Jackpot17/keyboard/keyboard/keyboard.kicad_pcb

## KiCad design keyboard/keyboard.kicad_pcb (2026-11-12)

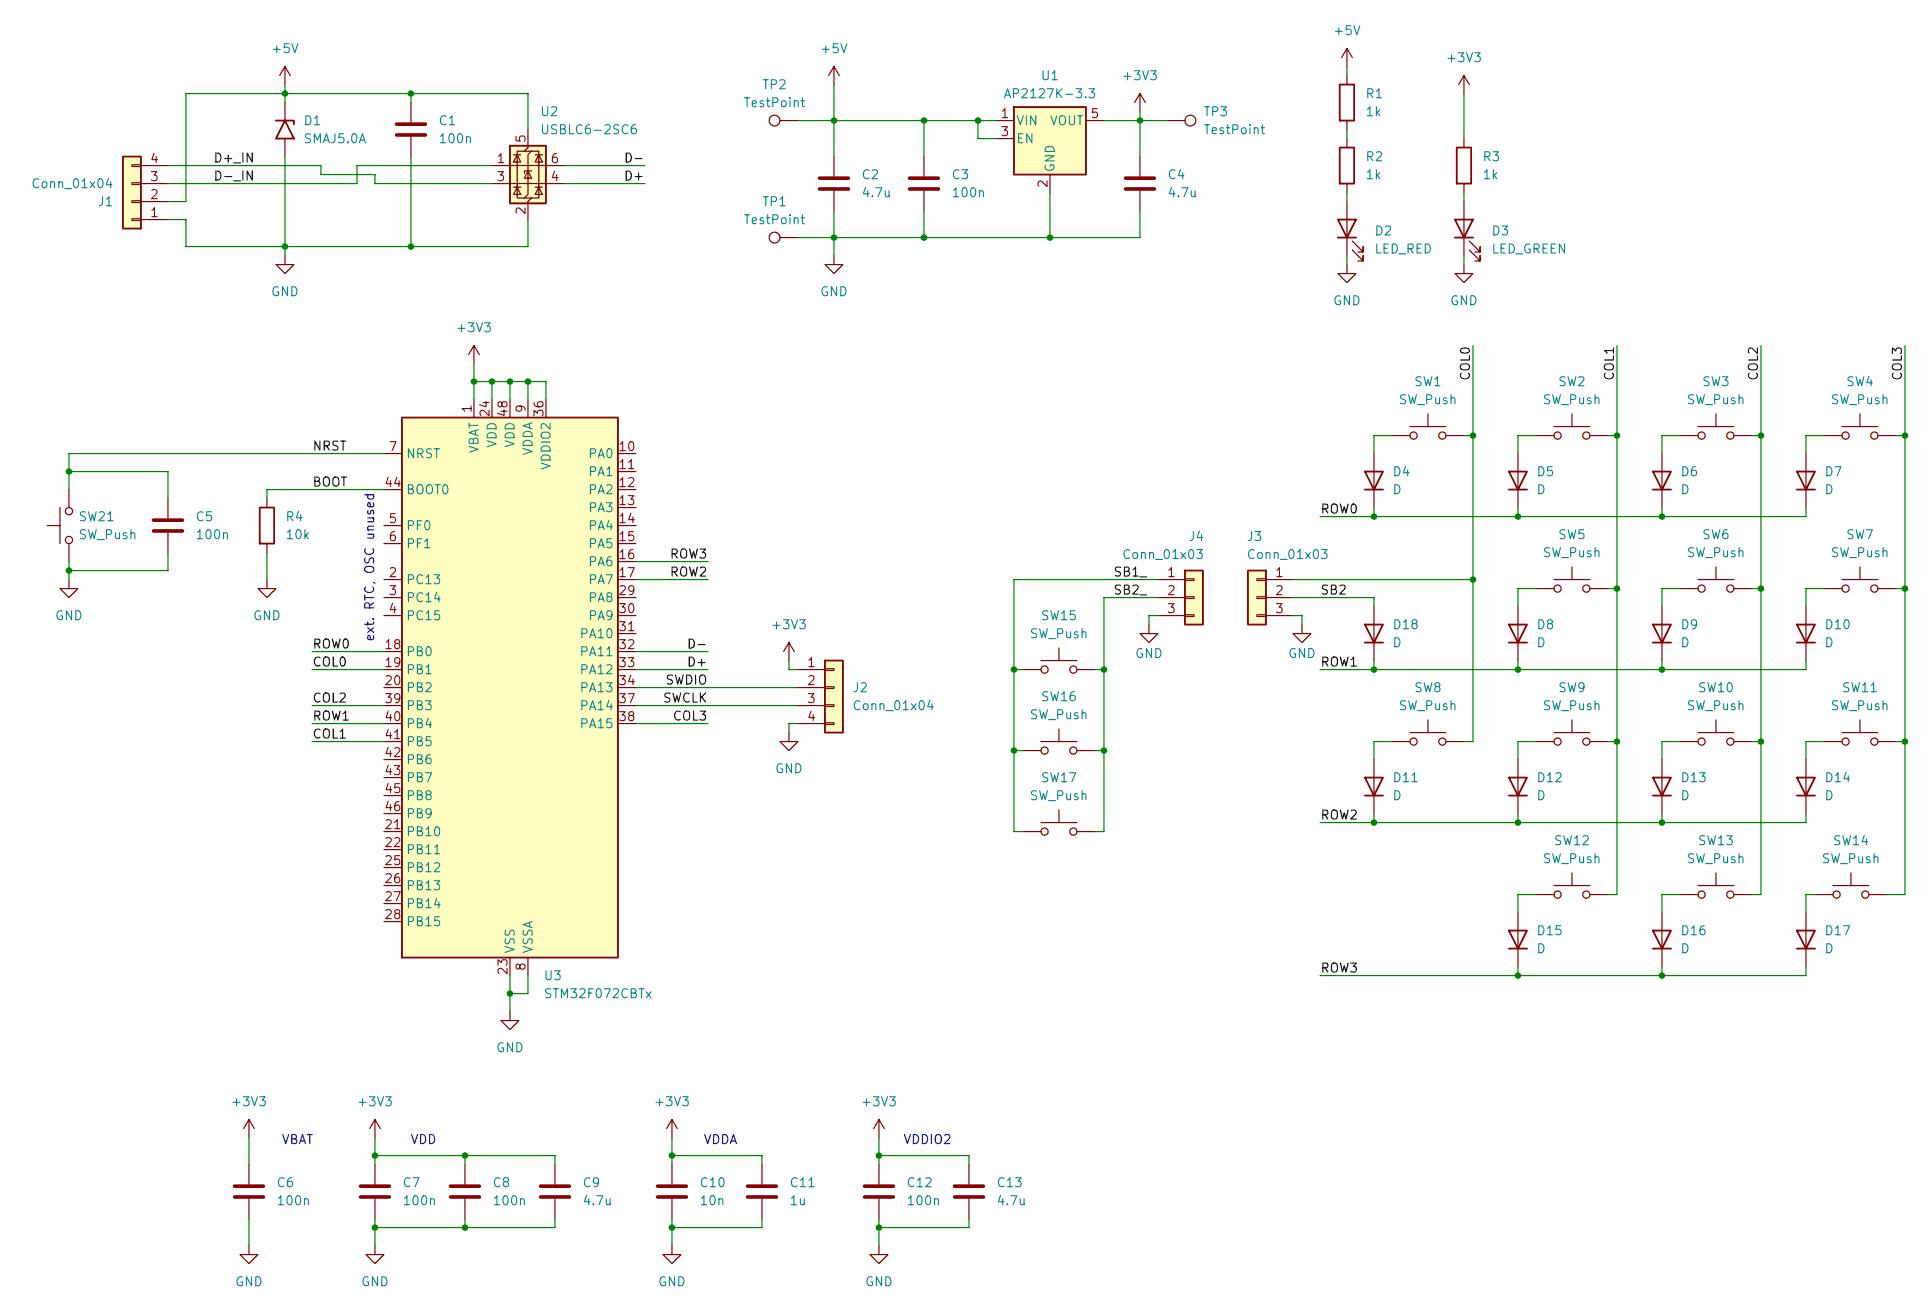
[picture p1: schematic keyboard.kicad_sch]

Parts:
C1, C3, C5, C6, C7, C8, C12: 100n; C_0603_1608Metric
C2, C4: 4.7u; C_0805_2012Metric
C9, C13: 4.7u; C_0603_1608Metric
C10: 10n; C_0603_1608Metric
C11: 1u; C_0603_1608Metric
D1: SMAJ5.0A; D_SMA
D2: LED_RED; LED_0603_1608Metric
D3: LED_GREEN; LED_0603_1608Metric
D4, D5, D6, D7, D8, D9, D10, D11, D12, D13, D14, D15, D16, D17, D18: D; D_SOD-323
J1: Conn_01x04
J2: Conn_01x04; PinHeader_1x04_P1.27mm_Vertical
J3, J4: Conn_01x03
R1, R2, R3: 1k; R_0603_1608Metric
R4: 10k; R_0603_1608Metric
SW1, SW2, SW3, SW4, SW5, SW6, SW7, SW8, SW9, SW10, SW11, SW12, SW13, SW14, SW15, SW16, SW17: SW_Push; SW_MX_HS_KS-2P02B01-01_1.5u
SW21: SW_Push; SW_SPST_TL3305A
TP1, TP2, TP3: TestPoint; TestPoint_Pad_D1.0mm
U1: AP2127K-3.3; SOT-23-5
U2: USBLC6-2SC6; SOT-23-6
U3: STM32F072CBTx; LQFP-48_7x7mm_P0.5mm

Connections:
+3V3: C4.1, C6.1, C7.1, C8.1, C9.1, C10.1, C11.1, C12.1, C13.1, J2.1, R3.1, TP3.1 (1_1), U1.5 (VOUT), U3.1 (VBAT), U3.9 (VDDA), U3.24 (VDD), U3.36 (VDDIO2), U3.48 (VDD)
+5V: C1.1, C2.1, C3.1, D1.1 (A1), J1.2, R1.1, TP2.1 (1_1), U1.1 (VIN), U1.3 (EN), U2.5 (VBUS); also elsewhere on the board
/BOOT: R4.1, U3.44 (BOOT0)
/COL0: J3.1, SW1.2, SW8.2, U3.19 (PB1); also elsewhere on the board
/COL1: SW2.2, SW5.2, SW9.2, SW12.2, U3.41 (PB5)
/COL2: SW3.2, SW6.2, SW10.2, SW13.2, U3.39 (PB3)
/COL3: SW4.2, SW7.2, SW11.2, SW14.2, U3.38 (PA15)
/D+: U2.4 (I/O2), U3.33 (PA12)
/D+_IN: J1.4, U2.3 (I/O2); also elsewhere on the board
/D-: U2.6 (I/O1), U3.32 (PA11)
/D-_IN: J1.3, U2.1 (I/O1); also elsewhere on the board
/NRST: C5.1, SW21.2, U3.7 (NRST)
/ROW0: D4.1 (K), D5.1 (K), D6.1 (K), D7.1 (K), U3.18 (PB0)
/ROW1: D8.1 (K), D9.1 (K), D10.1 (K), D18.1 (K), U3.40 (PB4)
/ROW2: D11.1 (K), D12.1 (K), D13.1 (K), D14.1 (K), U3.17 (PA7)
/ROW3: D15.1 (K), D16.1 (K), D17.1 (K), U3.16 (PA6)
/SB1_: J4.1, SW15.1, SW16.1, SW17.1; also elsewhere on the board
/SB2: D18.2 (A), J3.2; also elsewhere on the board
/SB2_: J4.2, SW15.2, SW16.2, SW17.2; also elsewhere on the board
/SWCLK: J2.3, U3.37 (PA14)
/SWDIO: J2.2, U3.34 (PA13)
GND: C1.2, C2.2, C3.2, C4.2, C5.2, C6.2, C7.2, C8.2, C9.2, C10.2, C11.2, C12.2, C13.2, D1.2 (A2), D2.1 (K), D3.1 (K), J1.1, J2.4, J3.3, J4.3, R4.2, SW21.1, TP1.1 (1_1), U1.2 (GND), U2.2 (GND), U3.8 (VSSA), U3.23 (VSS), U3.35 (VSS), U3.47 (VSS); also elsewhere on the board
unnamed: D2.2 (A), R2.2
unnamed: D3.2 (A), R3.2
unnamed: D4.2 (A), SW1.1
unnamed: D5.2 (A), SW2.1
unnamed: D6.2 (A), SW3.1
unnamed: D7.2 (A), SW4.1
unnamed: D8.2 (A), SW5.1
unnamed: D9.2 (A), SW6.1
unnamed: D10.2 (A), SW7.1
unnamed: D11.2 (A), SW8.1
unnamed: D12.2 (A), SW9.1
unnamed: D13.2 (A), SW10.1
unnamed: D14.2 (A), SW11.1
unnamed: D15.2 (A), SW12.1
unnamed: D16.2 (A), SW13.1
unnamed: D17.2 (A), SW14.1
unnamed: R1.2, R2.1

Notes on the sheet:
ext. RTC, OSC unused
VDD
VBAT
VDDA
VDDIO2

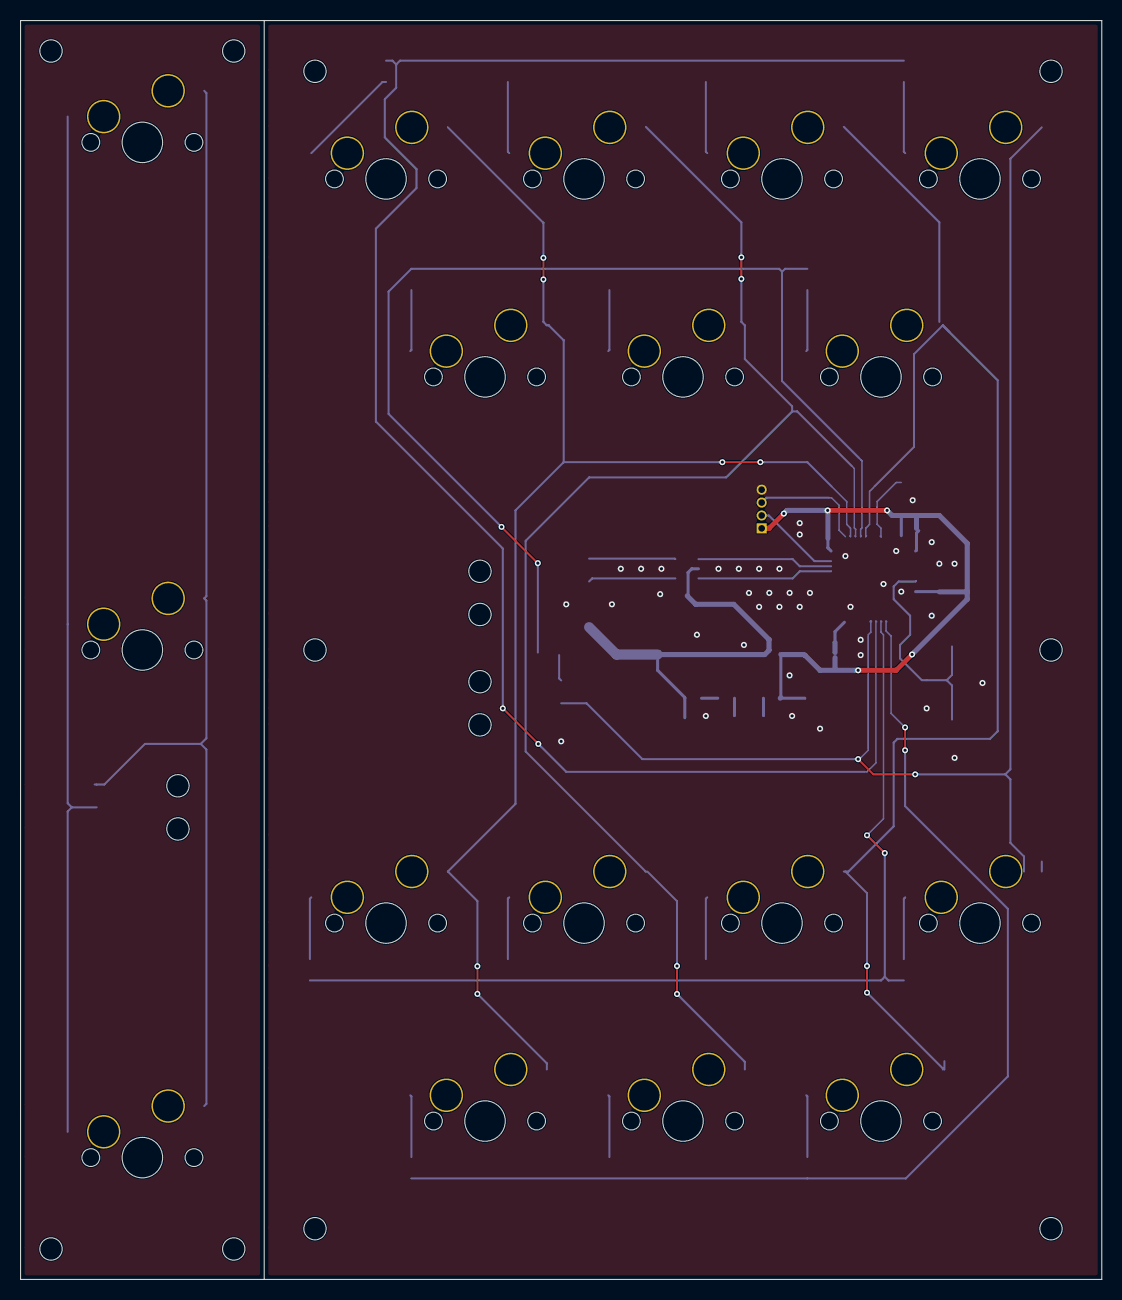
[picture p2: board keyboard.kicad_pcb from above]

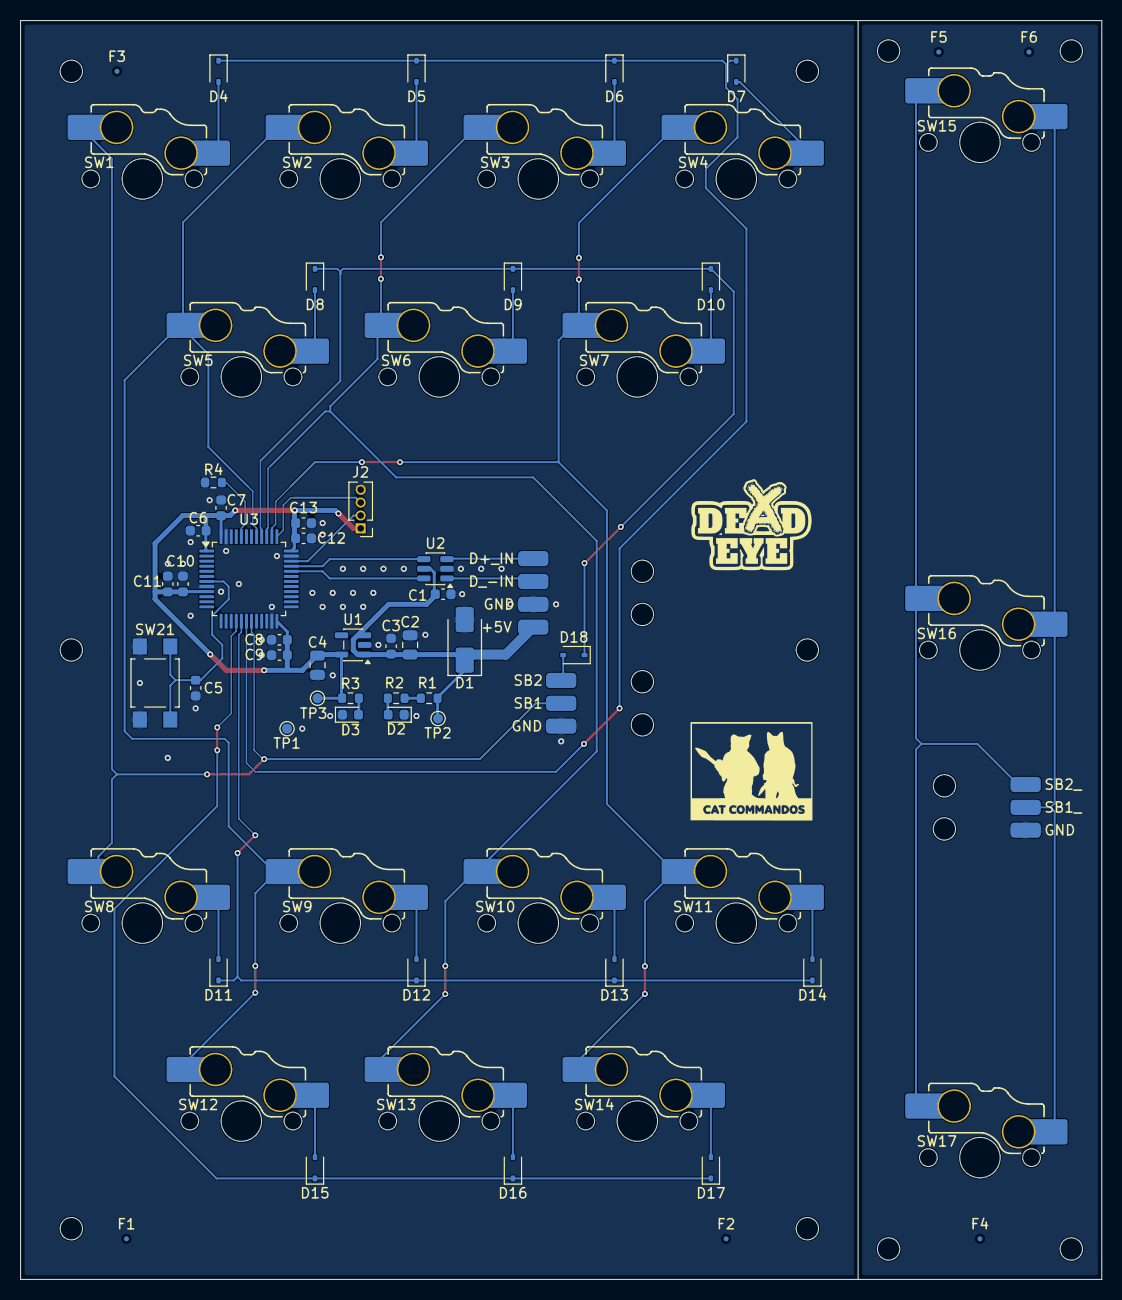
[picture p3: board keyboard.kicad_pcb from below]

Board: 2 copper layers, 106.5 x 124.0 mm, 76 parts (76 on the bottom side), 39 nets.

Other parts of the board:
+5V: SolderWirePad_1x01_SMD_1.5x3mm
D+_IN: SolderWirePad_1x01_SMD_1.5x3mm
D_-IN: SolderWirePad_1x01_SMD_1.5x3mm
F1, F2, F3, F4, F5, F6: Fiducial_0.5mm_Mask1mm
GND: SolderWirePad_1x01_SMD_1.5x3mm
GND#2, GND#3: SolderWirePad_1x01_SMD_1.5x3mm
SB1, SB1_, SB2, SB2_: SolderWirePad_1x01_SMD_1.5x3mm

Their connections:
+5V: +5V.1; also elsewhere on the board
/COL0: SB1.6; also elsewhere on the board
/D+_IN: D+_IN.4; also elsewhere on the board
/D-_IN: D_-IN.3; also elsewhere on the board
/SB1_: SB1_.9; also elsewhere on the board
/SB2: SB2.7; also elsewhere on the board
/SB2_: SB2_.10; also elsewhere on the board
GND: GND.5, GND#2.2, GND#3.8; also elsewhere on the board
