Jackpot17/keyboard/(commit log)

2026-05-11 Schematic complete, initial component placement on PCB. Not reviewed.
    [keyboard.kicad_pcb, keyboard.kicad_sch]
2026-05-14 Key layout according to TB drawing.
    [keyboard.kicad_pcb]
2026-05-15 Added board outlines 12mm from key switch centres.
    [keyboard.kicad_pcb, keyboard.kicad_sch]
2026-05-15 Added connector cutout and V-groove for cut. Moved dimensions onto user drawings layer.
    [keyboard.kicad_pcb]
2026-05-15 Some mounting holes.
    [keyboard.kicad_pcb]
2026-05-18 Some switch traces.
    [keyboard.kicad_pcb]
2026-06-05 Some routing.
    [keyboard.kicad_pcb, keyboard.kicad_sch]
2026-11-05 Add ground connection to spacebar board.
2026-11-05 Improve routing around wire management holes.
2026-11-05 Addional routing improvement around management holes.
2026-11-05 Adjust track.
2026-11-12 Bunch up some resistors.
2026-11-12 Move mounting holes.
2026-11-12 Got rid of kink in trace.
